betrusted-io/usbc_tester/hw/README.md

For reference only! These may not be up to date.

Note there are a couple ECOs only remarked in the schematic, but
not reflected in the PCB layout or gerbers.
