betrusted-io/usbc_tester/hw/case/tester-base^usbc-test-v1.STL

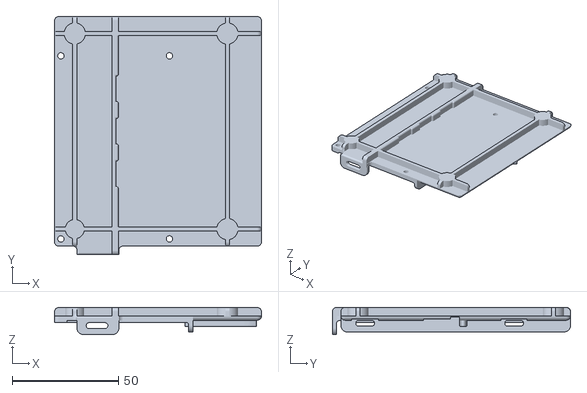
[picture p1: CAD file, 2021-12-07]
hw/case/tester-base^usbc-test-v1.STL
97.2 x 111.9 x 12.7
