betrusted-io/usbc_tester/hw/usbc-test-v1.pdf

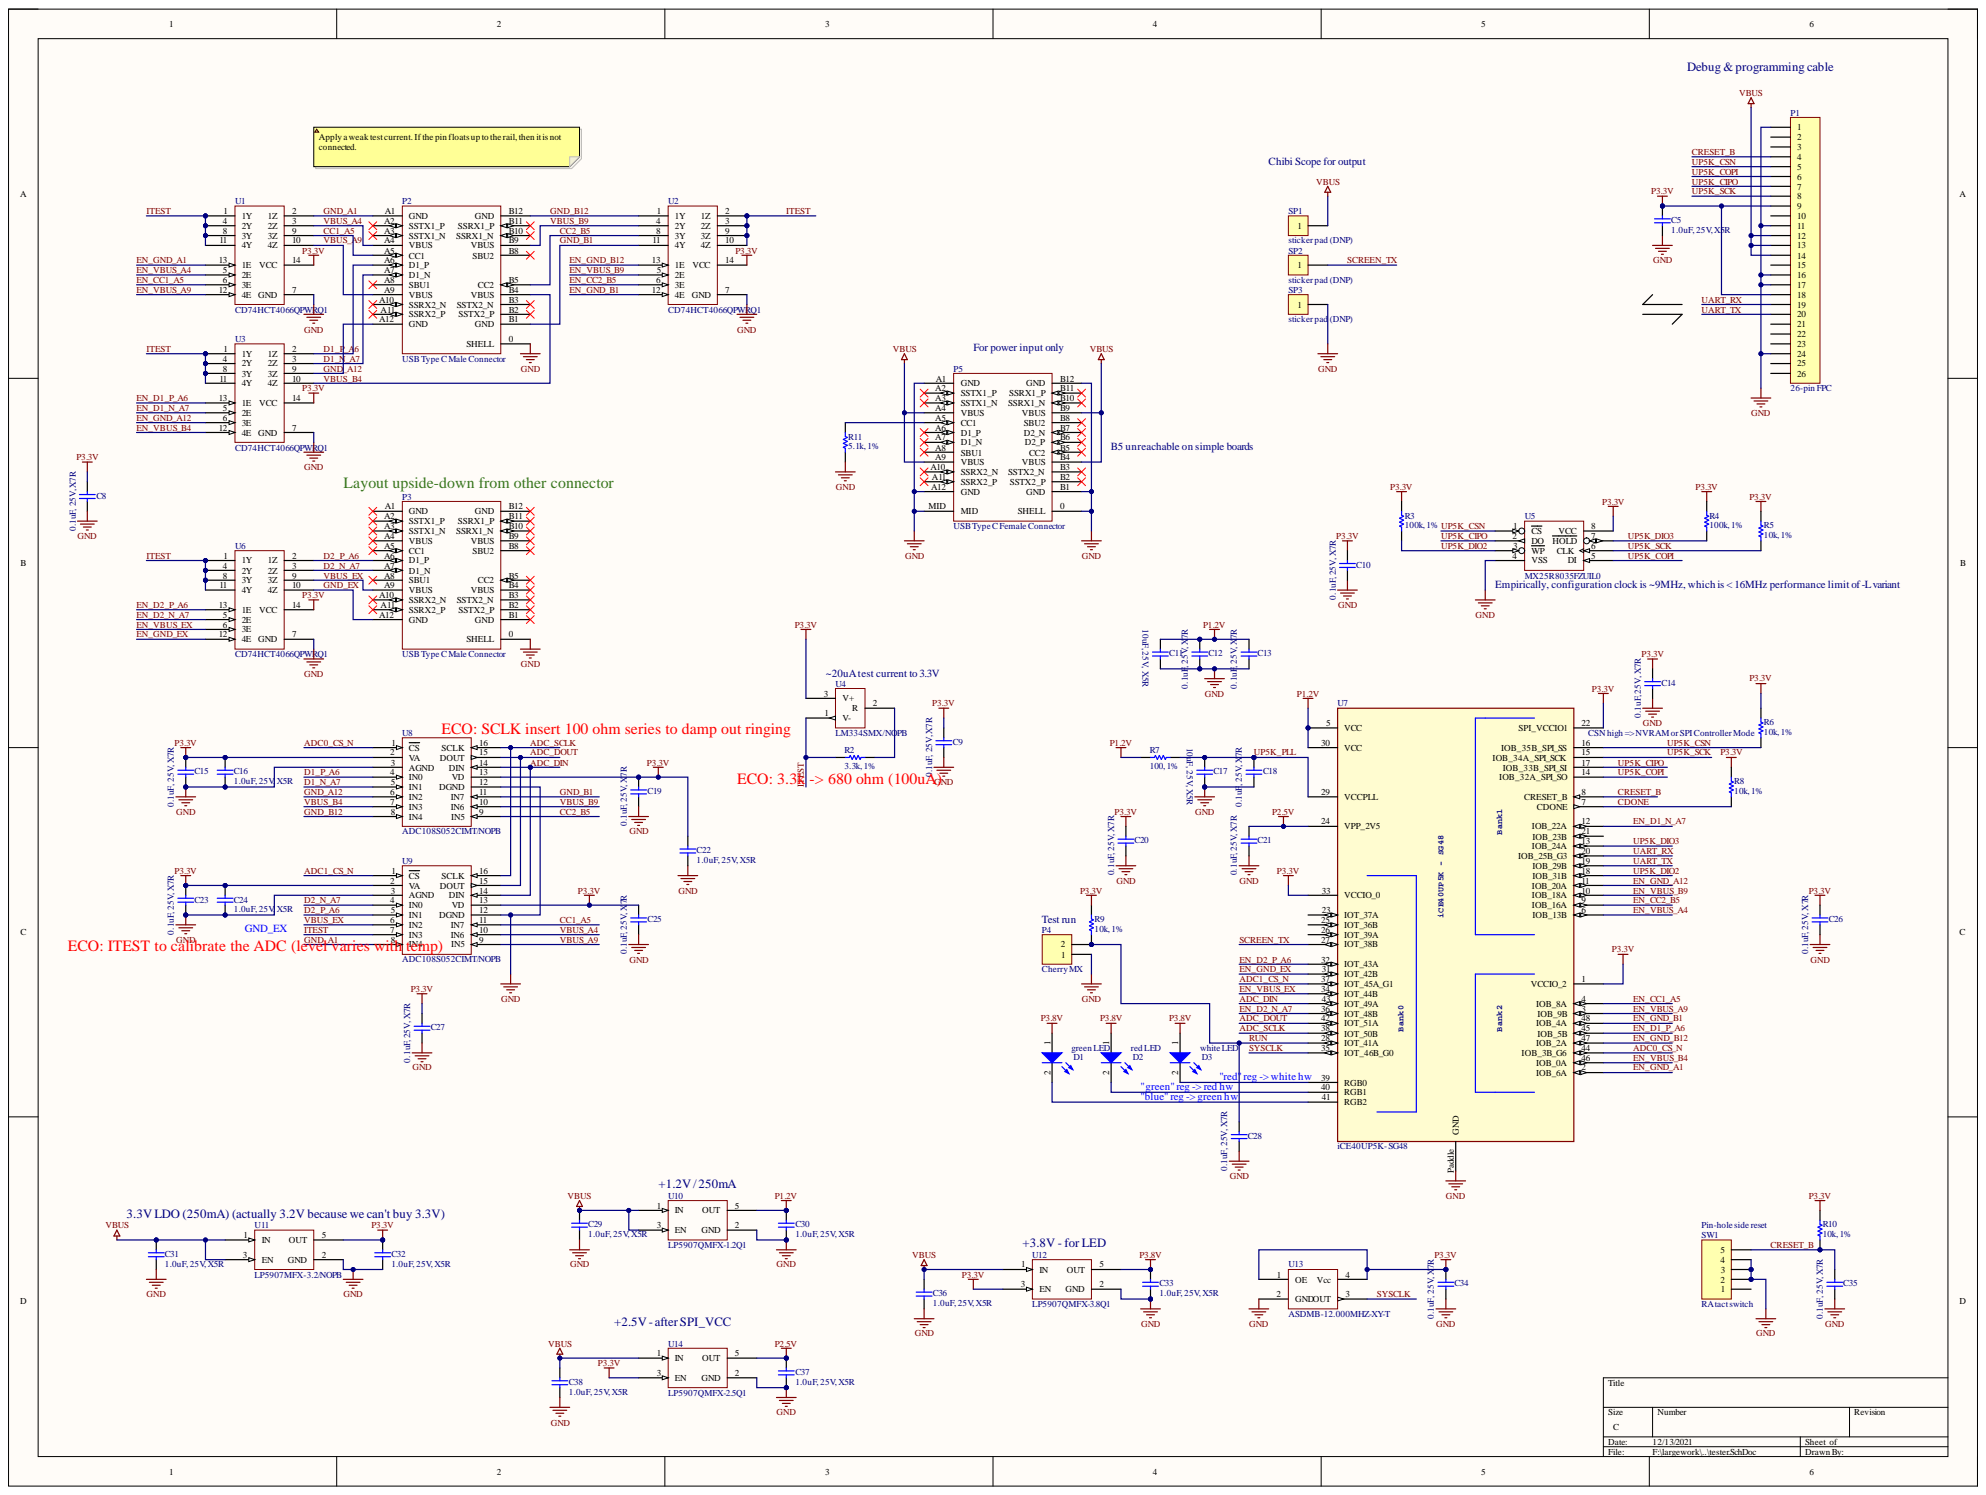
[picture p2: page 1]

Apply a weak test current.If the pin floats up to the rail, then itis not
connected.

Chibi Scope for output

For power input only

B5 unreachable on simple boards

GND
Layout upside-down from other connector

MX25R8035FZUIL0
Empirically, configuration clock is ~9MHz, which is < 16MHz performance limit of -Lvariant

ECO: SCLK insert 100 ohm series to damp out ringing

CSN high =>NVRAMor SPI Controller Mode

ECO: ITEST to calibrate the ADC (level varies with temp)

red LED
"red" reg -> white hw "green" reg -> red hw "blue" reg -> green hw

3.3V LDO (250mA) (actually 3.2V because we can't buy 3.3V)

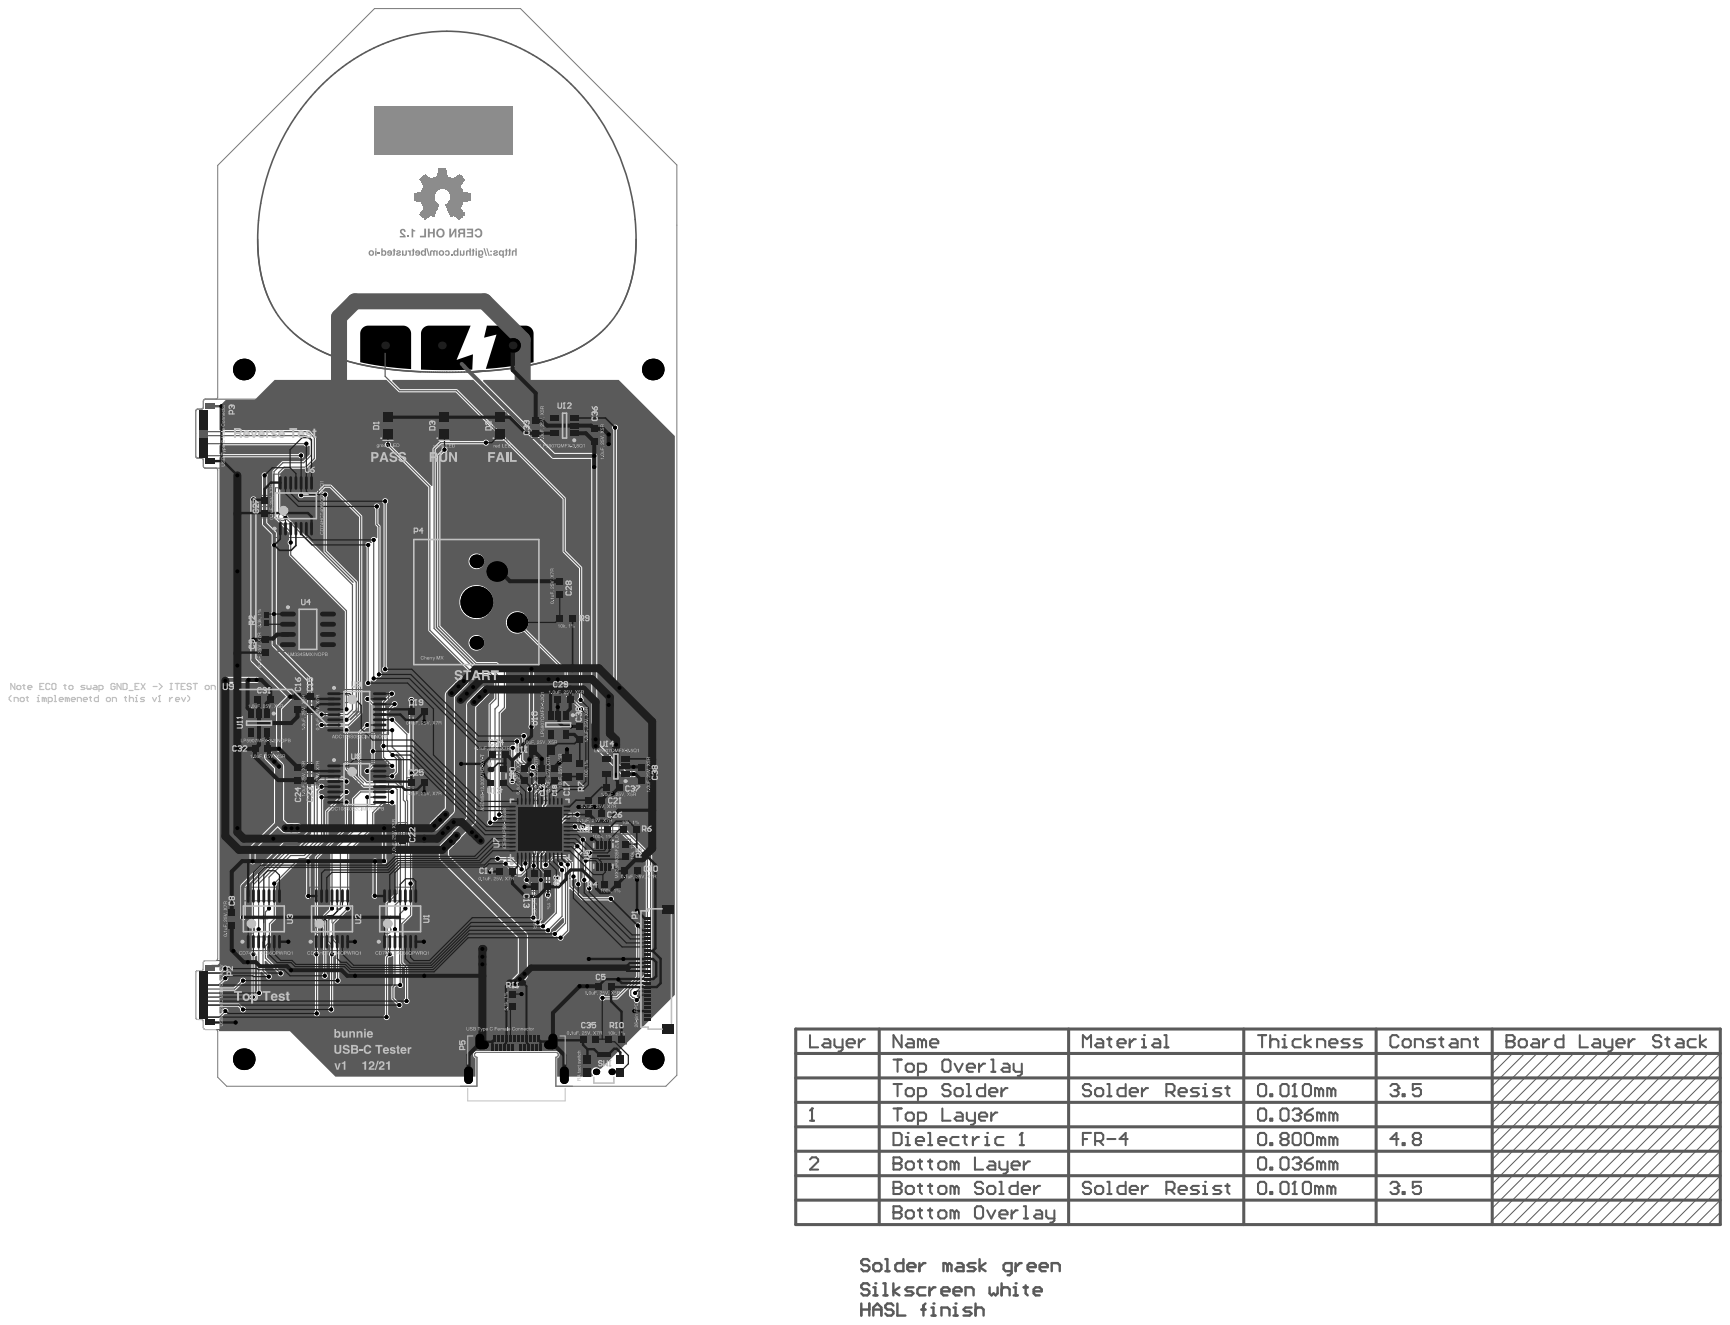
[picture p3: page 2]
