betrusted-io/usbc_tester/(list of files, drawings)

Other design files:
hw/tester.SchDoc
hw/usbc-test-v1.PcbDoc
hw/usbc-test-v1.PrjPcb
