betrusted-io/usbc_tester/(commit log)

2021-12-05 a very skeletal build that works end-to-end. trying rv32-im target.
    [csr.csv]
2021-12-05 add peripherals, check that utilization is OK -- "imc" is a go
    [csr.csv]
2021-12-05 add a running status signal to the ADC
2021-12-06 update pinouts
    [csr.csv]
2021-12-06 update the ADC driver to a 10-bit part
    the 8-bit part was sold out between the time i started the
    design 2 days ago, and the day i taped out the board :-/
    fortunately, it's "just" a firmware change to use the more
    expensive 10-bit part, which is actually in stock.
    [csr.csv]
2021-12-07 some initial frameworks for the tester
    [csr.csv]
2021-12-07 add some hardware reference files
    [tester-base^usbc-test-v1.STL, tester.SchDoc, usbc-test-v1.PcbDoc, usbc-test-v1.PrjPcb]
2021-12-08 first draft of the tester code, with all the operations "complete"
    surely, there are many, many bugs to be found. but at least
    we'll be able to start with finding them instead of waiting to
    write the test once the parts get in.
    [adc.rs, generate.rs, main.rs, sbled.rs, screen.rs]
2021-12-12 trying to debug baffling behavior of the ADC
    [csr.csv]
2021-12-12 you know how they say it's never a bad chip?
    it was just one of those days. test works now.
    [csr.csv]
2021-12-12 update hardware docs
    [tester.SchDoc]
